sdesalas/esp8266-climate-control/climate_control/data/admin/esp.jpg

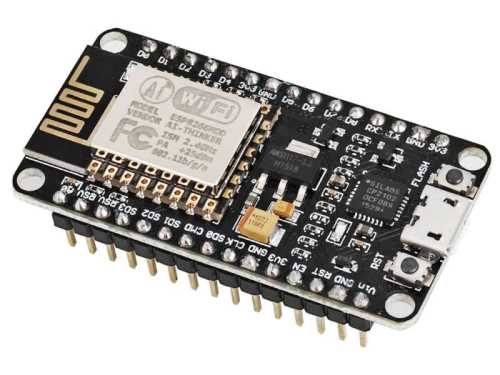
climate_control/data/admin/esp.jpg
