sdesalas/esp8266-climate-control/(commit log)

2024-04-24 VS Code C++ Arduino settings + various
2024-04-27 Review chart logic and library optimal size
    [history.csv]
2024-04-28 Factory reset on FLASH, and various upgrades
    [FS.ino, GPIO.ino, Settings.ino, WebServer.ino, Wifi.ino, climate_control.ino]
2024-05-05 Reorganize GPIOs, Metrics factory reset.
    [GPIO.ino, Metrics.ino]
2024-06-07 README + fileorg + fixes
    [WebServer.ino]
2024-06-18 Fix start date on historical charts
    [history.csv]
